courtneyjkeeler/PSU/report.txt

Info: Front (top side) placement file: 'C:\Users\david\Documents\GitHub\PSU\GReX_Power-top-pos.csv'.
Info: Component count: 39.
Info: Back (bottom side) placement file: 'C:\Users\david\Documents\GitHub\PSU\GReX_Power-bottom-pos.csv'.
Info: Component count: 0.
Info: Full component count: 39.
Info: File generation successful.
