courtneyjkeeler/PSU/(commit log)

2022-11-10 Fixed missing output connection
    [GReX_Power.kicad_pcb, GReX_Power.kicad_sch]
2023-10-30 First updates
    Joined terminals, defaulted relay gate to 12V, added additional terminal blocks for GPS and amps
    [GReX_Power.kicad_pcb, GReX_Power.kicad_sch]
2023-12-13 commit of fabricated v2
    includes files sent to JLCPCB
    [GReX_Power-B_Cu.gbl, GReX_Power-B_Mask.gbs, GReX_Power-B_Paste.gbp, GReX_Power-B_Silkscreen.gbo, GReX_Power-Edge_Cuts.gm1, GReX_Power-F_Cu.gtl, GReX_Power-F_Mask.gts, GReX_Power-F_Paste.gtp]
